qwertymodo/opulo-feeder/pcb/mobo/mobo.kicad_pcb

## KiCad design pcb/mobo/mobo.kicad_pcb (2023-09-29)

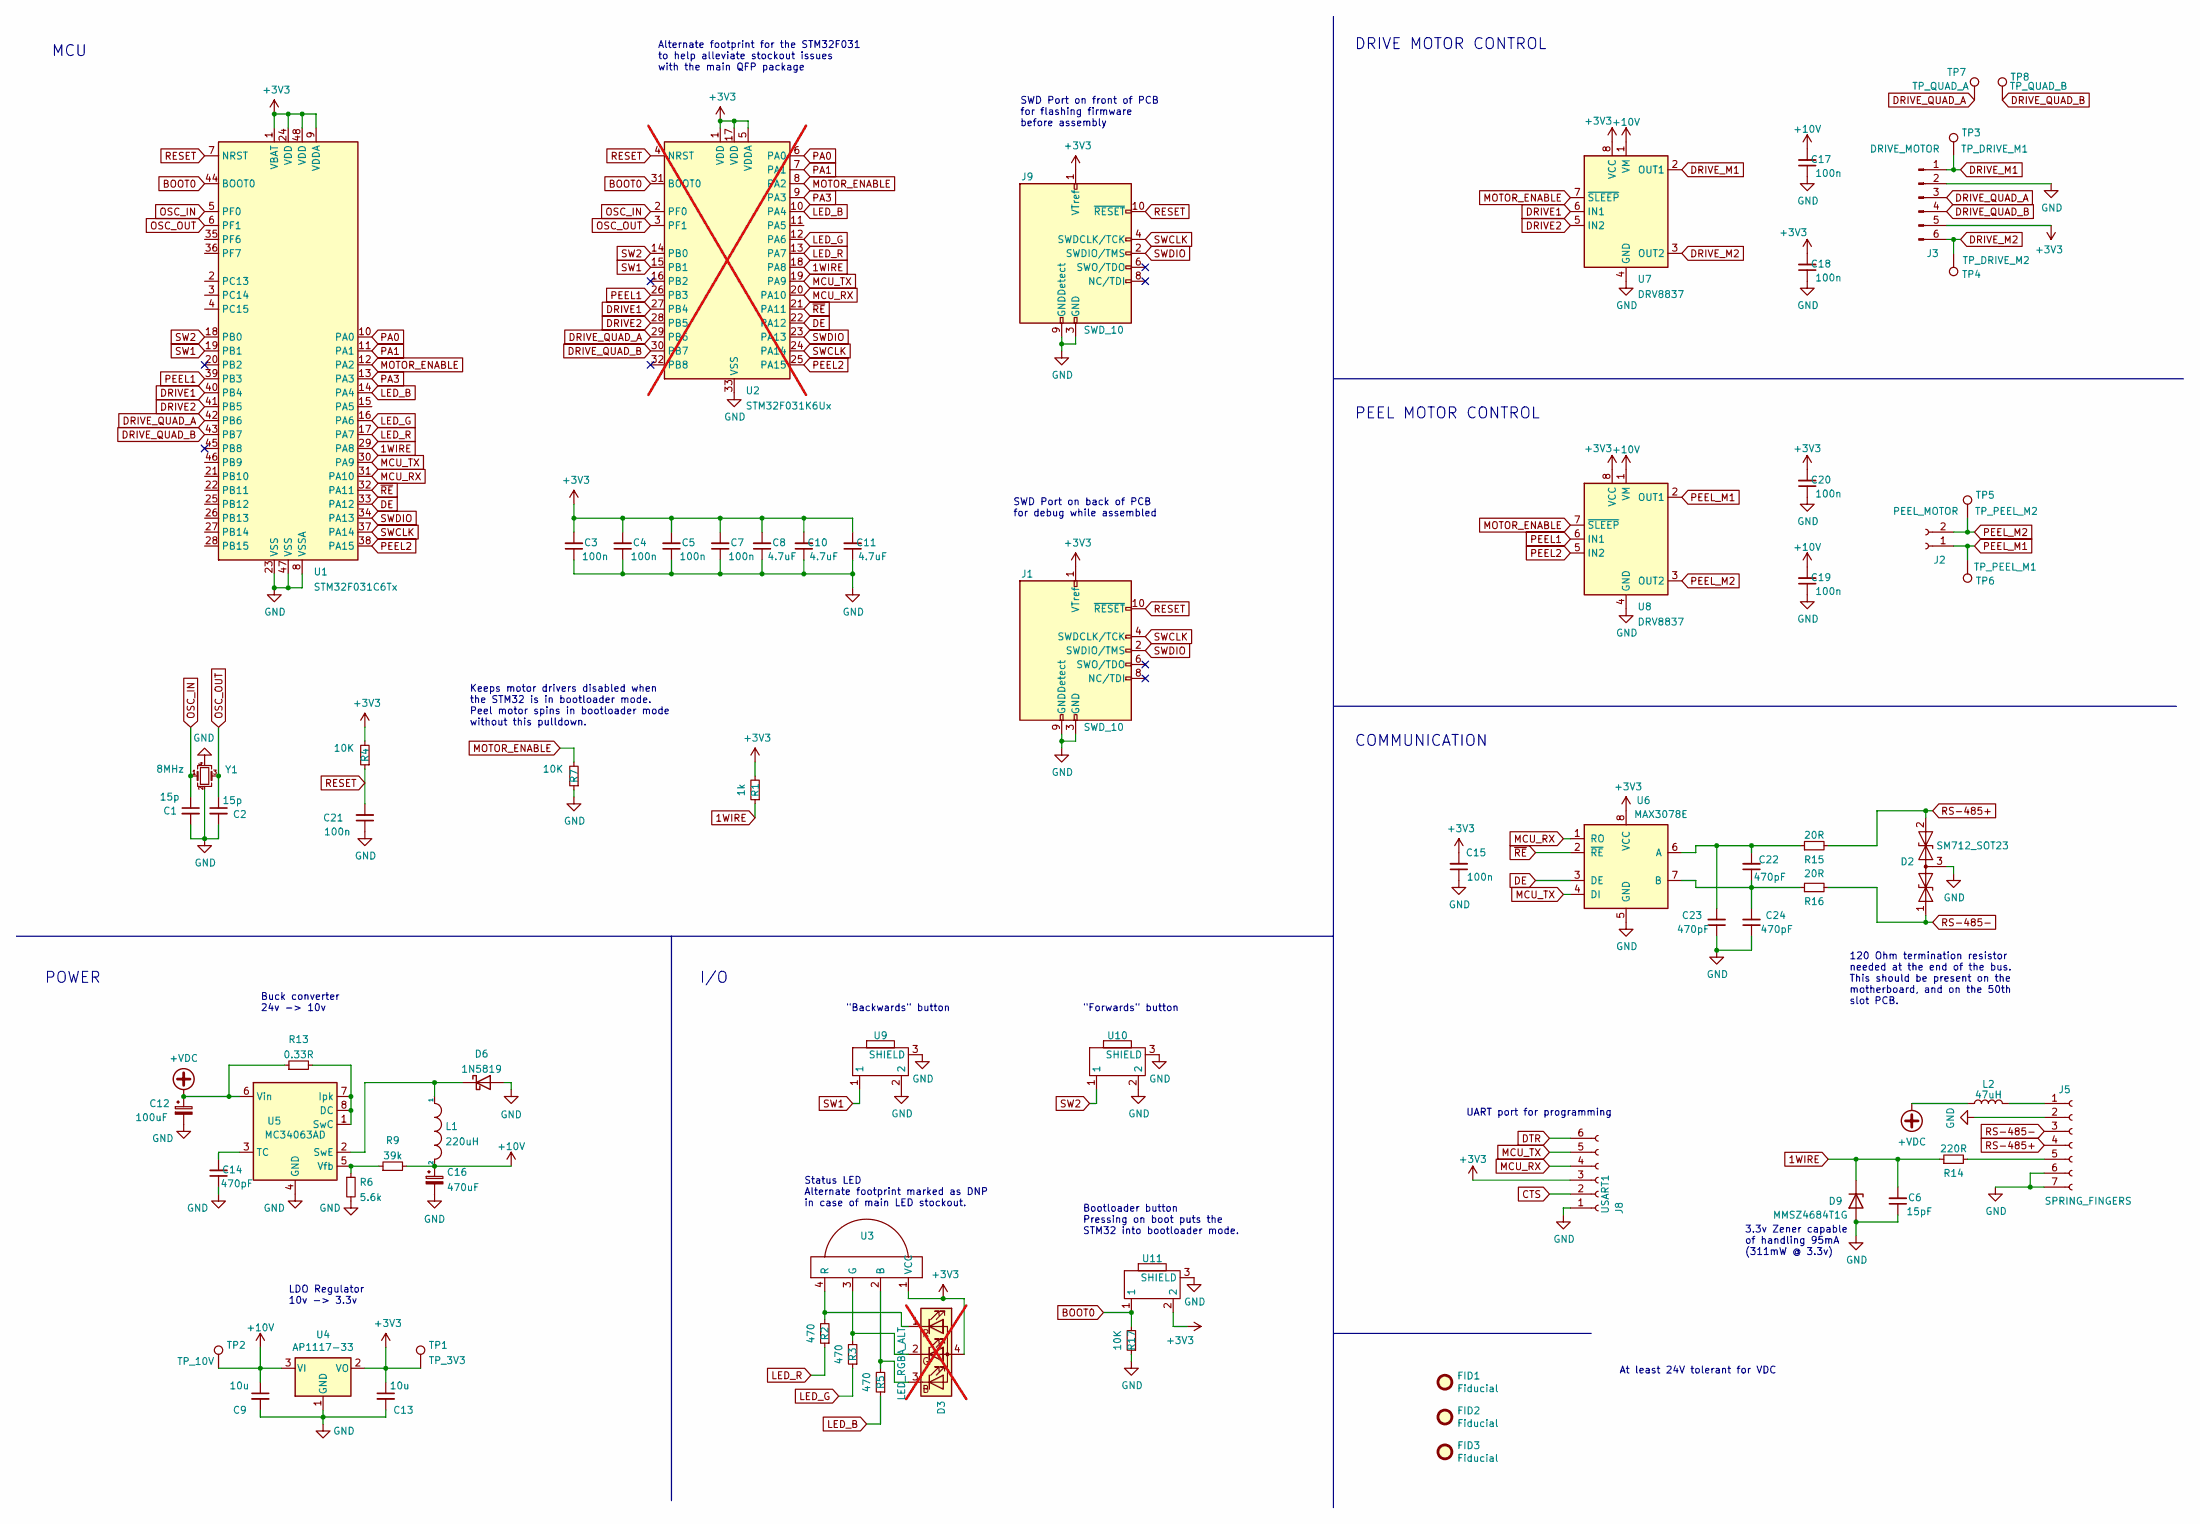
[picture p1: schematic mobo.kicad_sch, LumenPnP Feeder Control Board]

Parts:
C1, C2: 15p; C_0805_2012Metric; JLCPCB C1794
C3, C4, C5, C7, C15, C17, C18, C19, C20, C21: 100n; C_0805_2012Metric; JLCPCB C49678
C6: 15pF; C_0805_2012Metric; JLCPCB C49678
C8, C10, C11: 4.7uF; C_0805_2012Metric; JLCPCB C49678
C9, C13: 10u; C_0805_2012Metric; JLCPCB C15850
C12: 100uF; C_Elec_6.3x7.7
C14, C22, C23, C24: 470pF; C_0805_2012Metric; JLCPCB C49678
C16: 470uF; C_Elec_8x10.2
D2: SM712_SOT23; SOT-23; LCSC C521963
D3: LED_RGBA_ALT; LED_LiteOn_LTST-C19HE1WT; not fitted
D6: 1N5819; D_SOD-123
D9: MMSZ4684T1G; D_SOD-123; JLCPCB MMSZ4684T1G
FID1, FID2, FID3: Fiducial; Fiducial_1mm_Mask2mm
J1, J9: SWD_10; PinHeader_2x05_P1.27mm_Vertical_SMD
J2: PEEL_MOTOR; Molex_PicoBlade_53261-0271_1x02-1MP_P1.25mm_Horizontal; LCSC C2845379
J3: DRIVE_MOTOR; Molex_PicoBlade_53261-0671_1x06-1MP_P1.25mm_Horizontal; LCSC C2845383
J5: SPRING_FINGERS; AVX-9155-005-541
J8: USART1; UART_FRICTION_FIT
L1: 220uH; L_6.3x6.3_H3; LCSC C467145
L2: 47uH; L_Sunlord_SWPA5020S
R1: 1k; R_0805_2012Metric; JLCPCB C17513
R2, R3, R5: 470; R_0805_2012Metric; JLCPCB C17710
R4, R7, R17: 10K; R_0805_2012Metric; JLCPCB C17513
R6: 5.6k; R_0805_2012Metric
R9: 39k; R_0805_2012Metric
R13: 0.33R; R_0805_2012Metric
R14: 220R; R_0805_2012Metric
R15, R16: 20R; R_0805_2012Metric
TP1: TP_3V3; TestPoint_Pad_D2.0mm
TP2: TP_10V; TestPoint_Pad_D2.0mm
TP3: TP_DRIVE_M1; TestPoint_Pad_D2.0mm
TP4: TP_DRIVE_M2; TestPoint_Pad_D2.0mm
TP5: TP_PEEL_M2; TestPoint_Pad_D2.0mm
TP6: TP_PEEL_M1; TestPoint_Pad_D2.0mm
TP7: TP_QUAD_A; TestPoint_Pad_D2.0mm
TP8: TP_QUAD_B; TestPoint_Pad_D2.0mm
U1: STM32F031C6Tx; LQFP-48_7x7mm_P0.5mm
U2: STM32F031K6Ux; QFN-32-No-Paste; not fitted
U3: MHS110FRGBCT
U4: AP1117-33; SOT-223-3_TabPin2; JLCPCB C108785
U5: MC34063AD; SOIC-8_3.9x4.9mm_P1.27mm
U6: MAX3078E; SOIC-8_3.9x4.9mm_P1.27mm; JLCPCB C40031
U7, U8: DRV8837; WSON-8-1EP_2x2mm_P0.5mm_EP0.9x1.6mm
U9, U10, U11: 1TS003B-1400-3500A-CT
Y1: 8MHz; Crystal_SMD_3225-4Pin_3.2x2.5mm_HandSoldering; JLCPCB C253751

Connections:
1WIRE: C6.2, D9.1 (K), R1.1, R14.1, U1.29 (PA8), U2.18 (PA8)
+3V3: C3.2, C4.2, C5.2, C7.2, C8.2, C10.2, C11.2, C13.1, C15.2, C18.2, C20.2, D3.4 (A), J1.1 (VTref), J3.5, J8.3, J9.1 (VTref), R1.2, R4.2, TP1.1, U1.1 (VBAT), U1.9 (VDDA), U1.24 (VDD), U1.48 (VDD), U2.1 (VDD), U2.5 (VDDA), U2.17 (VDD), U3.1 (VCC), U4.2 (VO), U6.8 (VCC), U7.8 (VCC), U8.8 (VCC), U11.2
+10V: C9.1, C16.1, C17.2, C19.2, L1.2, R9.2, TP2.1, U4.3 (VI), U7.1 (VM), U8.1 (VM)
+VDC: C12.1, L2.1, R13.1, U5.6 (Vin)
BOOT0: R17.2, U1.44 (BOOT0), U2.31 (BOOT0), U11.1
CTS: J8.2
DE: U1.33 (PA12), U2.22 (PA12), U6.3 (DE)
DRIVE1: U1.40 (PB4), U2.27 (PB4), U7.6 (IN1)
DRIVE2: U1.41 (PB5), U2.28 (PB5), U7.5 (IN2)
DRIVE_M1: J3.1, TP3.1, U7.2 (OUT1)
DRIVE_M2: J3.6, TP4.1, U7.3 (OUT2)
DRIVE_QUAD_A: J3.3, TP7.1, U1.42 (PB6), U2.29 (PB6)
DRIVE_QUAD_B: J3.4, TP8.1, U1.43 (PB7), U2.30 (PB7)
DTR: J8.6
GND: C1.2, C2.2, C3.1, C4.1, C5.1, C6.1, C7.1, C8.1, C9.2, C10.1, C11.1, C12.2, C13.2, C14.1, C15.1, C16.2, C17.1, C18.1, C19.1, C20.1, C21.1, C23.1, C24.1, D2.3 (common), D6.2 (A), D9.2 (A), J1.3 (GND), J1.5 (GND), J1.9 (GNDDetect), J3.2, J5.2, J5.6, J5.7, J8.1, J9.3 (GND), J9.5 (GND), J9.9 (GNDDetect), R6.2, R7.1, R17.1, U1.8 (VSSA), U1.23 (VSS), U1.47 (VSS), U2.33 (VSS), U4.1 (GND), U5.4 (GND), U6.5 (GND), U7.4 (GND), U7.9 (GND), U8.4 (GND), U8.9 (GND), U9.2, U9.3 (SHIELD), U10.2, U10.3 (SHIELD), U11.3 (SHIELD), Y1.2, Y1.4
LED_B: R5.1, U1.14 (PA4), U2.10 (PA4)
LED_G: R3.1, U1.16 (PA6), U2.12 (PA6)
LED_R: R2.1, U1.17 (PA7), U2.13 (PA7)
MCU_RX: J8.4, U1.31 (PA10), U2.20 (PA10), U6.1 (RO)
MCU_TX: J8.5, U1.30 (PA9), U2.19 (PA9), U6.4 (DI)
MOTOR_ENABLE: R7.2, U1.12 (PA2), U2.8 (PA2), U7.7 (~SLEEP), U8.7 (~SLEEP)
unnamed: D3.3 (BK), R5.2, U3.2 (B)
unnamed: D3.2 (GK), R3.2, U3.3 (G)
unnamed: D3.1 (RK), R2.2, U3.4 (R)
unnamed: D6.1 (K), L1.1, U5.2 (SwE)
unnamed: J5.1, L2.2
unnamed: J5.5, R14.2
unnamed: R13.2, U5.1 (SwC), U5.7 (Ipk), U5.8 (DC)
unnamed: C14.2, U5.3 (TC)
unnamed: R6.1, R9.1, U5.5 (Vfb)
unnamed: C22.2, C23.2, R15.1, U6.6 (A)
unnamed: C22.1, C24.2, R16.1, U6.7 (B)
OSC_IN: C1.1, U1.5 (PF0), U2.2 (PF0), Y1.1
OSC_OUT: C2.1, U1.6 (PF1), U2.3 (PF1), Y1.3
PA0: U1.10 (PA0), U2.6 (PA0)
PA1: U1.11 (PA1), U2.7 (PA1)
PA3: U1.13 (PA3), U2.9 (PA3)
PEEL1: U1.39 (PB3), U2.26 (PB3), U8.6 (IN1)
PEEL2: U1.38 (PA15), U2.25 (PA15), U8.5 (IN2)
PEEL_M1: J2.1, TP6.1, U8.2 (OUT1)
PEEL_M2: J2.2, TP5.1, U8.3 (OUT2)
RESET: C21.2, J1.10 (~RESET), J9.10 (~RESET), R4.1, U1.7 (NRST), U2.4 (NRST)
RS-485+: D2.2 (A2), J5.4, R15.2
RS-485-: D2.1 (A1), J5.3, R16.2
SW1: U1.19 (PB1), U2.15 (PB1), U9.1
SW2: U1.18 (PB0), U2.14 (PB0), U10.1
SWCLK: J1.4 (SWDCLK/TCK), J9.4 (SWDCLK/TCK), U1.37 (PA14), U2.24 (PA14)
SWDIO: J1.2 (SWDIO/TMS), J9.2 (SWDIO/TMS), U1.34 (PA13), U2.23 (PA13)
~RE: U1.32 (PA11), U2.21 (PA11), U6.2 (~RE)

Notes on the sheet:
LDO Regulator 10v -> 3.3v
I/O
PEEL MOTOR CONTROL
COMMUNICATION
DRIVE MOTOR CONTROL
Bootloader button Pressing on boot puts the STM32 into bootloader mode.
SWD Port on front of PCB for flashing firmware before assembly
POWER
Keeps motor drivers disabled when the STM32 is in bootloader mode. Peel motor spins in bootloader mode without this pulldown.
Alternate footprint for the STM32F031 to help alleviate stockout issues with the main QFP package
"Backwards" button
3.3v Zener capable of handling 95mA (311mW @ 3.3v)
At least 24V tolerant for VDC
Status LED Alternate footprint marked as DNP in case of main LED stockout.
SWD Port on back of PCB for debug while assembled
Buck converter 24v -> 10v
"Forwards" button
MCU
120 Ohm termination resistor needed at the end of the bus. This should be present on the motherboard, and on the 50th slot PCB.
UART port for programming

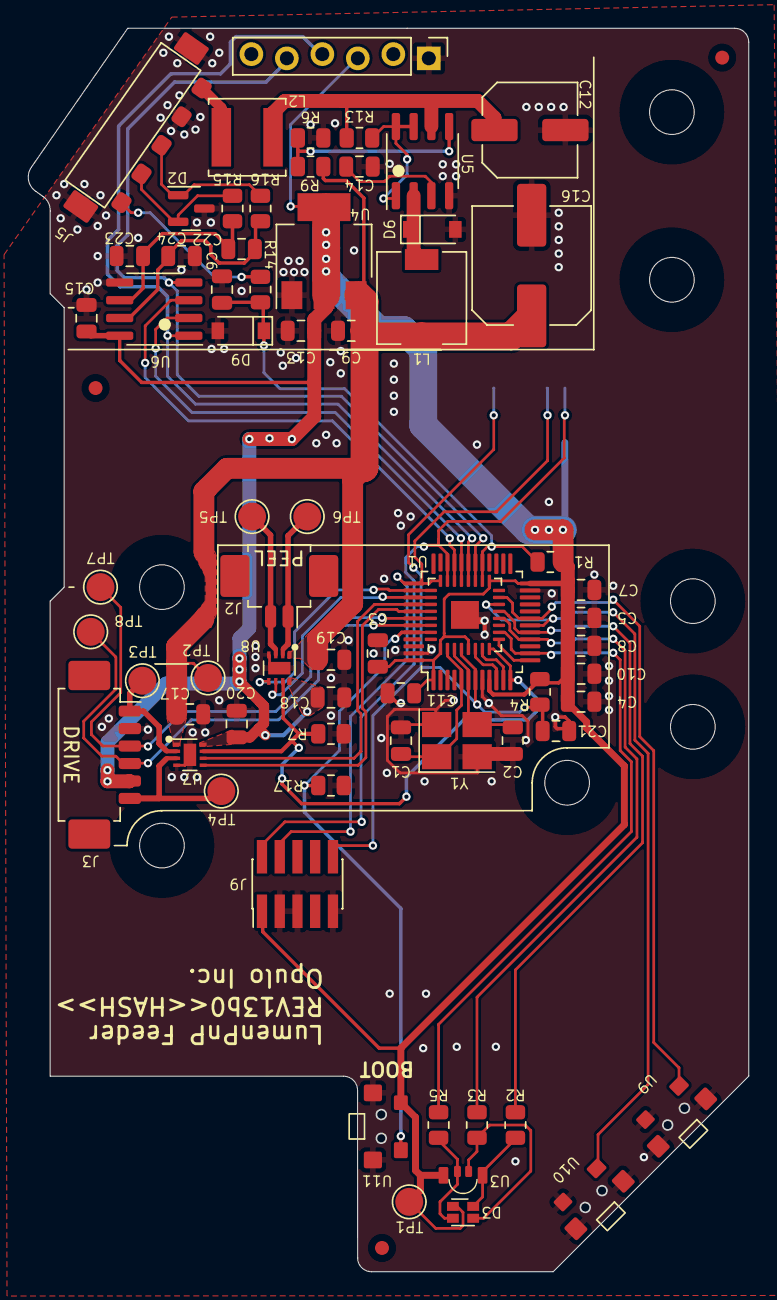
[picture p2: board mobo.kicad_pcb from above]

Board: 2 copper layers, 51.6 x 89.0 mm, 72 parts (1 on the bottom side), 47 nets.
