qwertymodo/opulo-feeder/(commit log)

2023-08-16 changed C16 footprint and repositioned slightly
    [mobo.kicad_pcb, mobo.kicad_sch]
2023-09-16 updated to 8mm filter cap footprint
    [mobo.kicad_pcb, mobo.kicad_sch]
2023-09-16 improved keepout clearance behind countersunk hole
    [mobo.kicad_pcb]
2023-09-16 Minor silkscreen and cosmetic fixes
    [mobo.kicad_pcb]
2023-09-29 Move a few components to fit inside the power supply compartment
    [mobo.kicad_pcb]
